EmbeddedDesign/ConsoleLights/hardware/img/ConsoleLights_Render.png

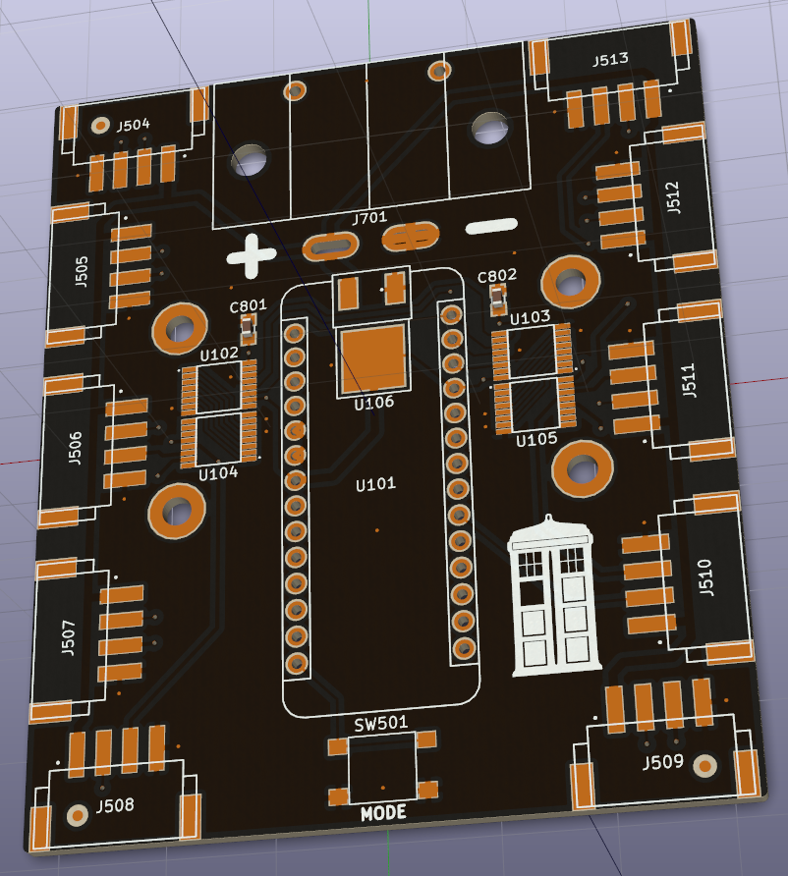
hardware/img/ConsoleLights_Render.png
