EmbeddedDesign/ConsoleLights/README.md

# ConsoleLights
Tardis Console Button and Light Controller
