EmbeddedDesign/ConsoleLights/hardware/img/ConsoleLights_NoPour.png

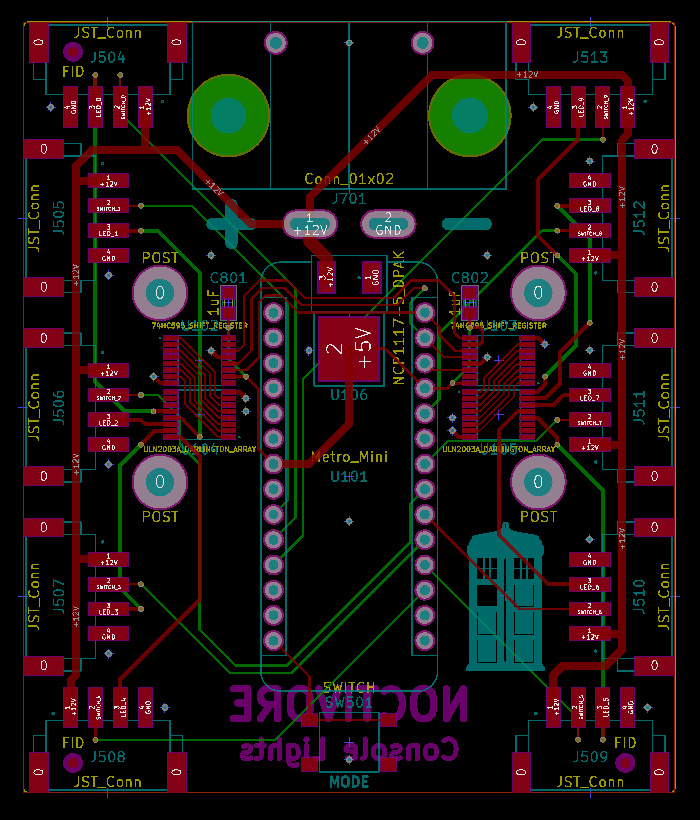
hardware/img/ConsoleLights_NoPour.png
