EmbeddedDesign/ConsoleLights/hardware/img/ConsoleLights_NoPour_Sheet.png

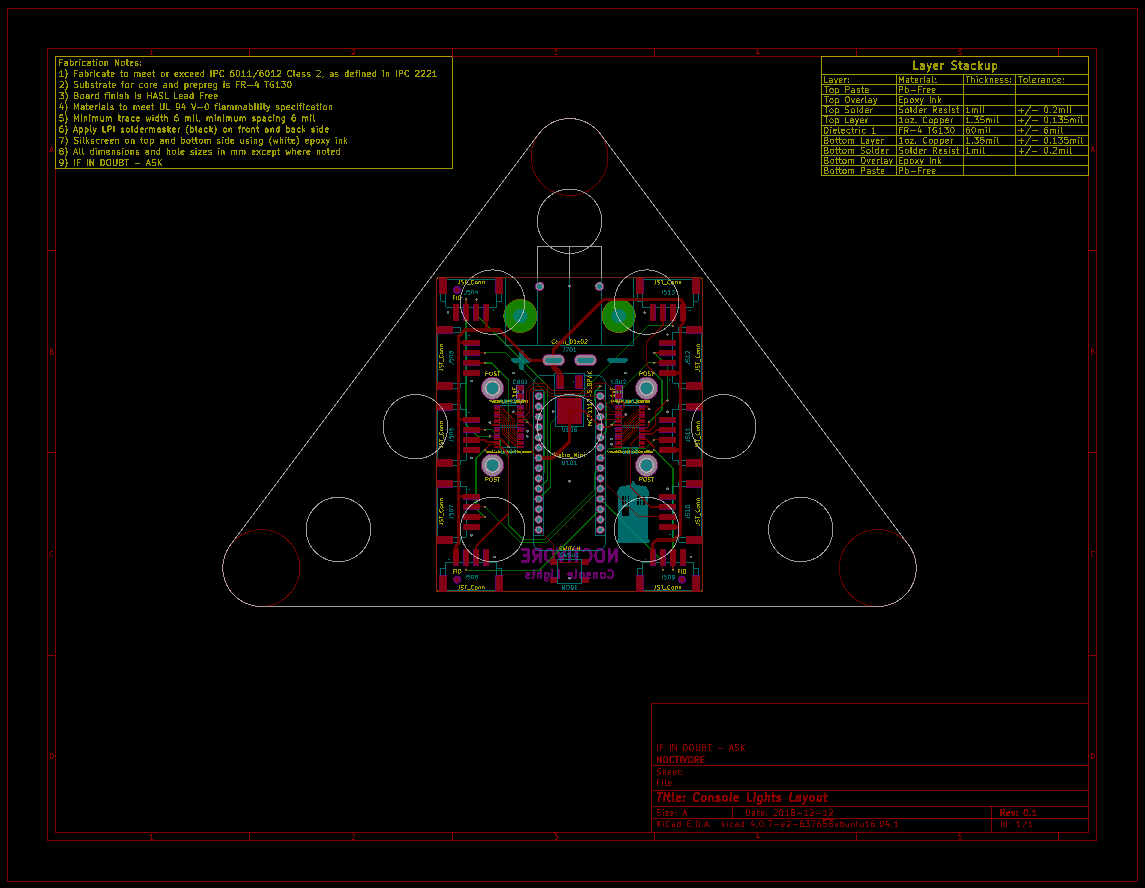
hardware/img/ConsoleLights_NoPour_Sheet.png
