EmbeddedDesign/ConsoleLights/hardware/Console_Lights_BOM.xlsx

Sheet: Console Lights PCBA
Console Lights PCBA BOM v0.1
REF | QTY | MRF | MFRPN | DESCRIPTION | PACKAGE | DATASHEET | LINK | 2ND SOURCE | ALT
U101 | 1 | Adafruit | 2590 | Metro Mini 328 5V 16MHz | Custom | https://cdn-learn.adafruit.com/downloads/pdf/adafruit-metro-mini.pdf | https://www.arrow.com/en/products/2590/adafruit-industries | https://www.adafruit.com/product/2590
U102, U103 | 2 | Nexperia | 74HC595PW-Q100,118 | 8-bit Shift Register | 16-TSSOP | https://assets.nexperia.com/documents/data-sheet/74HC_HCT595_Q100.pdf | https://www.arrow.com/en/products/74hc595pw-q100118/nexperia | https://www.digikey.com/product-detail/en/nexperia-usa-inc/74HC595PW-Q100118/1727-1012-1-ND/3749019 | MC74HC595ADTR2G, SN74HC595PWR
U104, U105 | 2 | TI | ULN2003APWR | High-Current Darlington Transistor Array | 16-TSSOP | http://www.ti.com/lit/ds/symlink/uln2003a.pdf | https://www.arrow.com/en/products/uln2003apwr/texas-instruments | https://www.digikey.com/product-detail/en/texas-instruments/ULN2003APWR/296-27173-1-ND/2255408 | ULN2003V12T16-13
U106 | 1 | On Semi | NCP1117DT50RKG | 5V Linear Regulator | DPAK | http://www.onsemi.com/pub/Collateral/NCP1117-D.PDF | https://www.arrow.com/en/products/ncp1117dt50rkg/on-semiconductor | https://www.digikey.com/products/en/integrated-circuits-ics/pmic-voltage-regulators-linear/699?k=NCP1117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
J501 | 1 | Anderson Power | ASMPR45-1X2-RK | Single Row 1x2 Powerpole Assembly | Custom | https://www.andersonpower.com/_global-assets/downloads/pdf/b02021s.pdf | https://www.mouser.com/ProductDetail/Anderson-Power-Products/ASMPR45-1X2-RK?qs=tub3WQyKOl%2FsXEao4JOdAw%3D%3D
J502, J503 | 2 | Sullins | PPPC141LFBN-RC | Conn Header Female 14POS 2.54mm | 2.54x14 | https://drawings-pdf.s3.amazonaws.com/10492.pdf | https://www.digikey.com/product-detail/en/sullins-connector-solutions/PPPC141LFBN-RC/S7047-ND/810186 |  | PPTC141LFBN-RC
J504-J513 | 10 | JST | S4B-XH-SM4-TB(LF)(SN) | Conn Header XH Side 4POS 2.5mm | Custom | http://www.jst-mfg.com/product/pdf/eng/eXH.pdf | https://www.arrow.com/en/products/s4b-xh-sm4-tb-lf-sn/jst-manufacturing | https://www.digikey.com/product-detail/en/jst-sales-america-inc/S4B-XH-SM4-TB-LF-SN/455-2262-1-ND/1651060 | http://www.farnell.com/datasheets/5448.pdf
C801, C802 | 2 | Samsung | CL10B105KP8NNNC | 1uF Capacitor, +/- 10%, 10V, X5/7R | 0603 | https://www.samsungsem.com/kr/support/product-search/mlcc/__icsFiles/afieldfile/2016/08/18/S_CL10B105KP8NNNC.pdf | https://www.arrow.com/en/products/cl10b105kp8nnnc/samsung-electro-mechanics | https://www.digikey.com/product-detail/en/samsung-electro-mechanics/CL10B105KP8NNNC/1276-1946-1-ND/3890032 | CL10B105KP8NNNC, 0603YC105KAT2A
SW1 | 1 | Panasonic | PTS645SM43SMTR92 LFS | SPST Off-Mom Tactile Switch | Custom | http://www.ckswitches.com/media/1471/pts645.pdf | https://www.arrow.com/en/products/pts645sm43smtr92lfs/ck | https://www.digikey.com/product-detail/en/c-k/PTS645SM43SMTR92-LFS/CKN9112CT-ND/1146934 | EVQ-Q2P02W, EVQ-Q2P03W, EVQ-Q2K03W

Sheet: Console Lights Other
Console Lights Other
QTY | MRF | MFRPN | DESCRIPTION | DATASHEET | LINK | 2ND SOURCE
40 | JST | SXH-001T-P0.6 | Conn Terminal Crimp XH 22AWG | http://www.jst-mfg.com/product/pdf/eng/eXH.pdf | https://www.digikey.com/product-detail/en/jst-sales-america-inc/SXH-001T-P0.6/455-1135-1-ND/527370 | https://www.arrow.com/en/products/sxh-001t-p0.6/jst-manufacturing
10 | JST | XHP-4 | Conn Housing 4POS 2.5mm | http://www.jst-mfg.com/product/pdf/eng/eXH.pdf | https://www.arrow.com/en/products/xhp-4/jst-manufacturing | https://www.digikey.com/product-detail/en/jst-sales-america-inc/XHP-4/455-2267-ND/683353
20 | TE | 42470-1 | Conn Quick Connect 0.110 x 0.020 Tab | https://www.te.com/commerce/DocumentDelivery/DDEController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 | https://www.digikey.com/product-detail/en/te-connectivity-amp-connectors/42470-1/42470-1-ND/298087 | https://www.arrow.com/en/products/42470-1/te-connectivity
20 | TE | 60118-1 | Conn Quick Connect 0.110 x 0.016 Tab | https://www.te.com/commerce/DocumentDelivery/DDEController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 | https://www.digikey.com/product-detail/en/te-connectivity-amp-connectors/60118-1/A27748CT-ND/456836
2 | Anderson Power | 1399G8-BK | Mounting Wing, Blue | https://www.mouser.com/datasheet/2/22/AndersonPower_01102017_DS-PP1545-1158138.pdf | https://www.mouser.com/ProductDetail/Anderson-Power-Products/1399G8-BK
1 | Anderson Power | 110G16 | Retaining Pin | https://www.mouser.com/datasheet/2/22/AndersonPower_01102017_DS-PP1545-1158138.pdf | https://www.mouser.com/ProductDetail/Anderson-Power-Products/110G16
1 | Anderson Power | 114555P2 | PCB Mounting Staple | https://www.andersonpower.com/_global-assets/downloads/pdf/b02021s.pdf | https://www.mouser.com/ProductDetail/Anderson-Power-Products/114555P2
2 | McMaster-Carr | 91290A383 | M3.5 Socket Head Screw 12mm Black Oxide | https://www.mcmaster.com/91290a383 | https://www.mcmaster.com/91290a383
2 | McMaster-Carr | 94150A330 | M3.5 Hex Nut | https://www.mcmaster.com/94150a330 | https://www.mcmaster.com/94150a330
2 | McMaster-Carr | 90965A140 | M3.5 316 Stainless Steel Washer | https://www.mcmaster.com/90965a140 | https://www.mcmaster.com/90965a140
