EmbeddedDesign/ConsoleLights/hardware/Console_Lights_Drawing.pdf

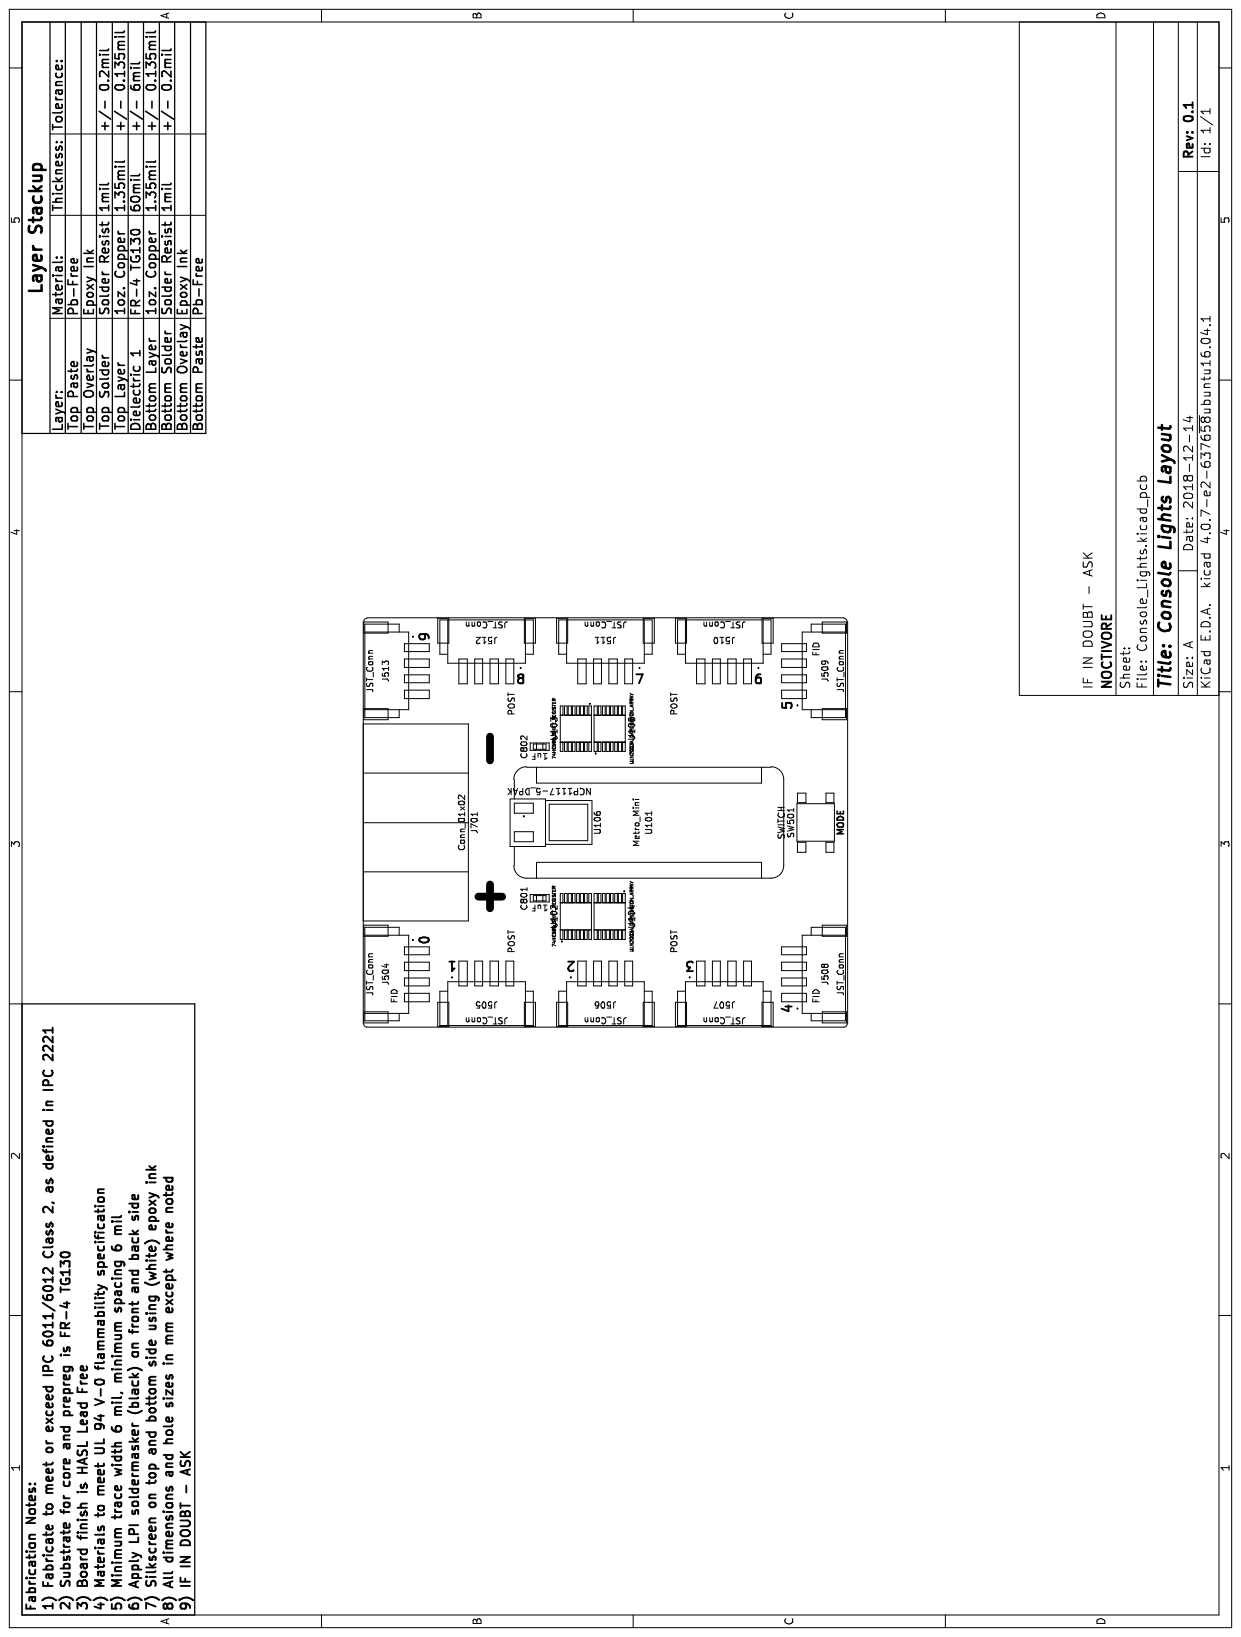
[picture p4: page 1]
