EmbeddedDesign/ConsoleLights/hardware/Console_Lights_Schematics.pdf

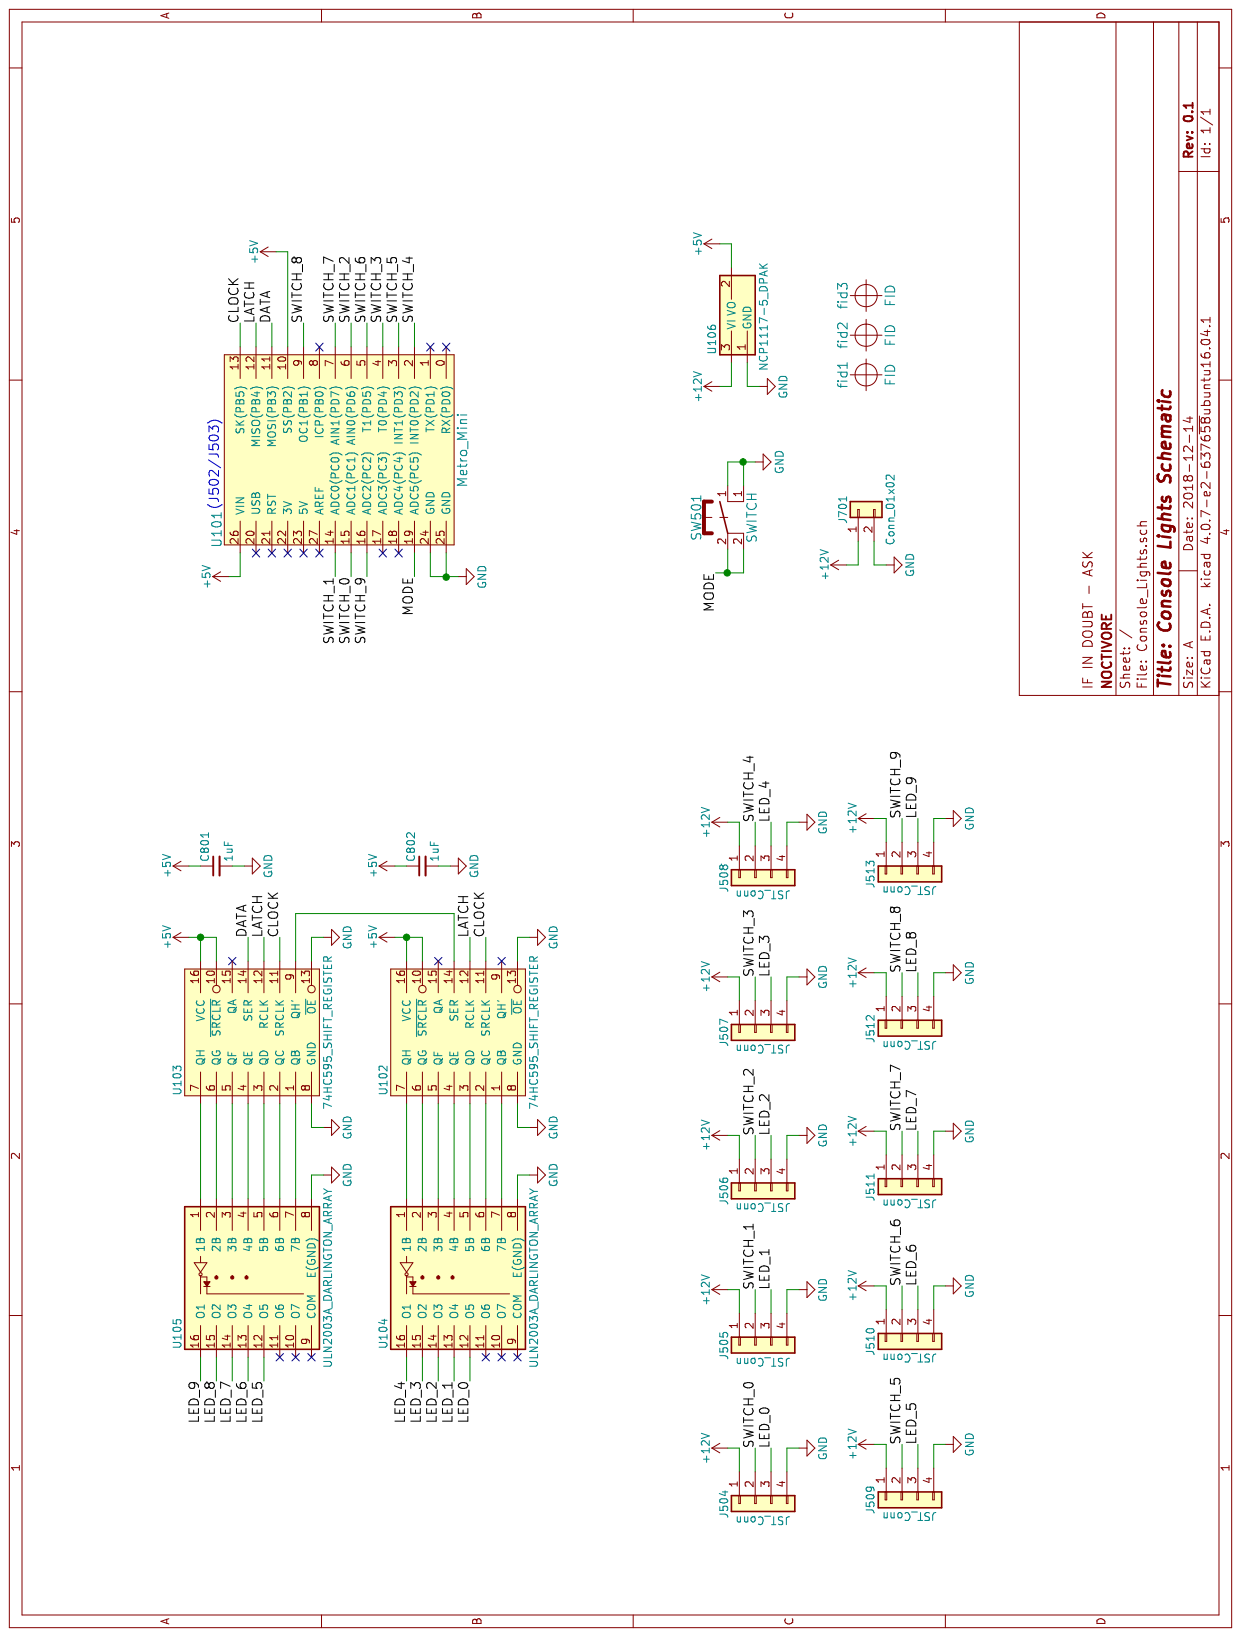
[picture p5: page 1]
