EmbeddedDesign/ConsoleLights/hardware/Console_Lights.kicad_pcb

## KiCad design hardware/Console_Lights.kicad_pcb (2018-12-18)

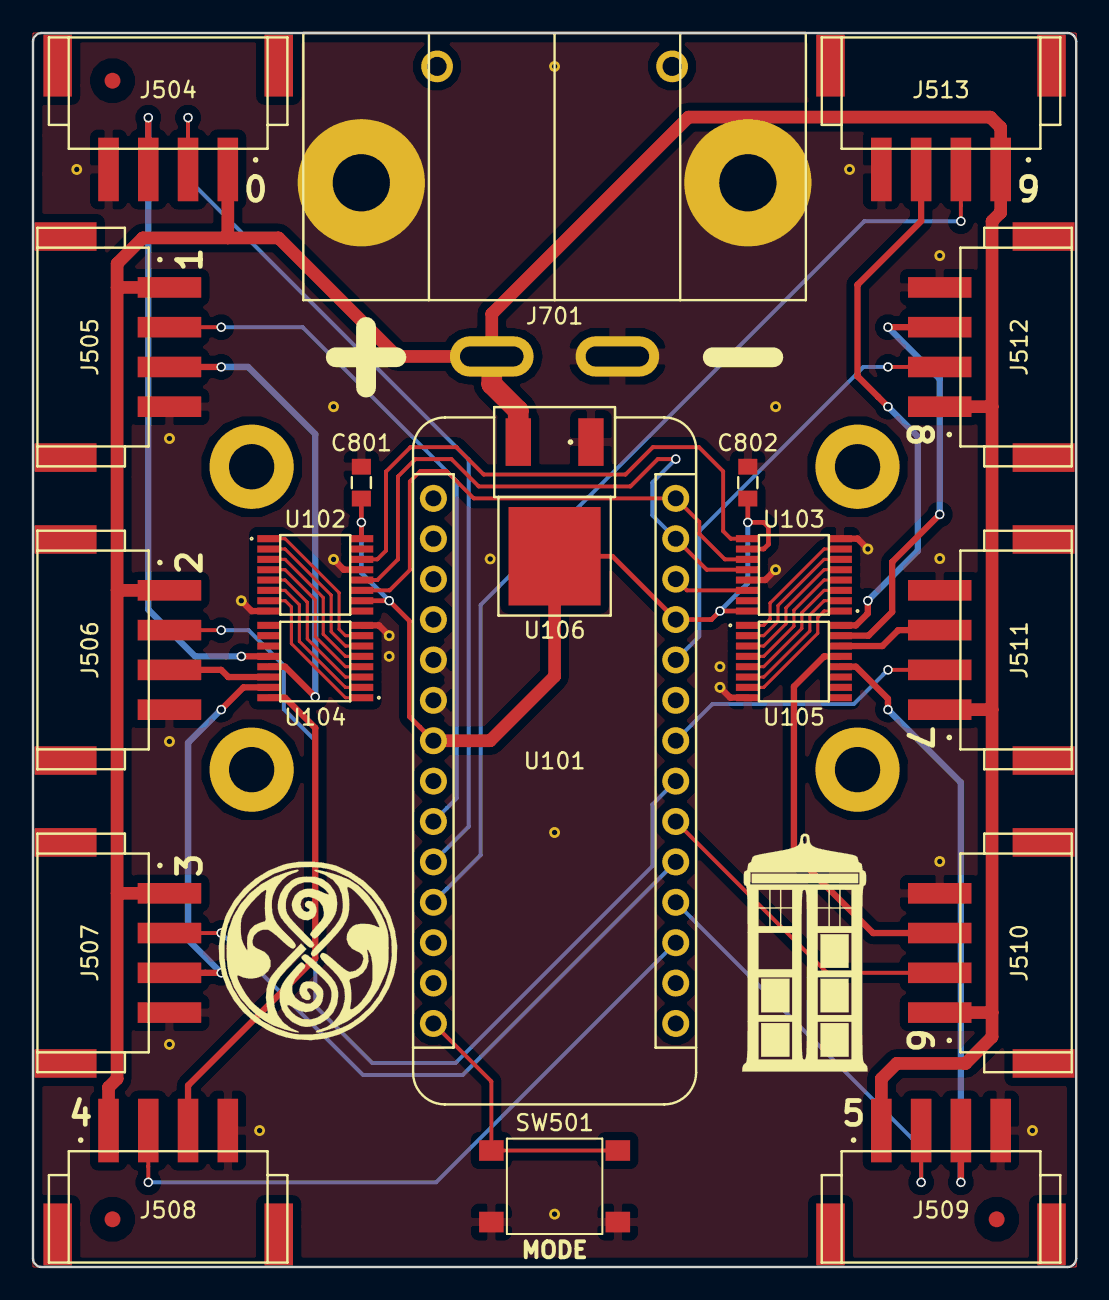
[picture p6: board Console_Lights.kicad_pcb from above]

Board: 2 copper layers, 65.6 x 77.6 mm, 23 parts (0 on the bottom side), 42 nets.

Parts:
C801, C802: 1uF; C_0603
J504, J505, J506, J507, J508, J509, J510, J511, J512, J513: JST_Conn; S4B-XH-SM4-TB
J701: Conn_01x02; ASMPR45-1X2-RK_Wings
SW501: SWITCH; CK_PTS645_Tac_Switch
U101: Metro_Mini
U102, U103: 74HC595_SHIFT_REGISTER; 16-TSSOP
U104, U105: ULN2003A_DARLINGTON_ARRAY; 16-TSSOP
U106: NCP1117-5_DPAK; DPAK_TO-252
fid1, fid2, fid3: FID; Fiducial

Connections:
+5V: C801.1, C802.1, U101.10, U101.26, U102.10, U102.16, U103.10, U103.16, U106.2
+12V: J504.1, J505.1, J506.1, J507.1, J508.1, J509.1, J510.1, J511.1, J512.1, J513.1, J701.1, U106.3
/CLOCK: U101.13, U102.11, U103.11
/DATA: U101.11, U103.14
/LATCH: U101.12, U102.12, U103.12
/LED_0: J504.3, U104.12
/LED_1: J505.3, U104.13
/LED_2: J506.3, U104.14
/LED_3: J507.3, U104.15
/LED_4: J508.3, U104.16
/LED_5: J509.3, U105.12
/LED_6: J510.3, U105.13
/LED_7: J511.3, U105.14
/LED_8: J512.3, U105.15
/LED_9: J513.3, U105.16
/MODE: SW501.2, U101.19
/SWITCH_0: J504.2, U101.15
/SWITCH_1: J505.2, U101.14
/SWITCH_2: J506.2, U101.6
/SWITCH_3: J507.2, U101.4
/SWITCH_4: J508.2, U101.2
/SWITCH_5: J509.2, U101.3
/SWITCH_6: J510.2, U101.5
/SWITCH_7: J511.2, U101.7
/SWITCH_8: J512.2, U101.9
/SWITCH_9: J513.2, U101.16
GND: C801.2, C802.2, J504.4, J505.4, J506.4, J507.4, J508.4, J509.4, J510.4, J511.4, J512.4, J513.4, J701.2, SW501.1, U101.24, U101.25, U102.8, U102.13, U103.8, U103.13, U104.8, U105.8, U106.1
unnamed: U102.1, U104.7
unnamed: U102.2, U104.6
unnamed: U102.3, U104.5
unnamed: U102.4, U104.4
unnamed: U102.5, U104.3
unnamed: U102.6, U104.2
unnamed: U102.7, U104.1
unnamed: U102.14, U103.9
unnamed: U103.1, U105.7
unnamed: U103.2, U105.6
unnamed: U103.3, U105.5
unnamed: U103.4, U105.4
unnamed: U103.5, U105.3
unnamed: U103.6, U105.2
unnamed: U103.7, U105.1
