EmbeddedDesign/ConsoleLights/hardware/Quick_Connect_Wiring.png

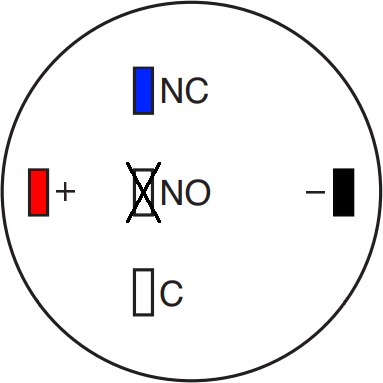
hardware/Quick_Connect_Wiring.png
