EmbeddedDesign/ConsoleLights/(commit log)

2018-10-31 creat lib, add footprints, schematic updates
    [Console_Lights.kicad_pcb, Console_Lights.sch]
2018-11-02 add footprints, BOM, schematic updates
    [Console_Lights.kicad_pcb, Console_Lights.sch, Console_Lights_BOM.xlsx]
2018-11-07 BOM, footprint updates
    [Console_Lights.kicad_pcb, Console_Lights.sch, Console_Lights_BOM.xlsx]
2018-11-09 add regulator, BOM, schematic, layout updates
    [Console_Lights.kicad_pcb, Console_Lights.sch, Console_Lights_BOM.xlsx]
2018-11-10 mounting plate outline, floor-planning
    [Console_Lights.kicad_pcb]
2018-11-29 schematic/routing update
    [Console_Lights.kicad_pcb, Console_Lights.sch]
2018-11-30 routing updates
    [Console_Lights.kicad_pcb, Console_Lights.sch]
2018-11-30 routing updates, logo
    [Console_Lights.kicad_pcb, Console_Lights.sch]
2018-12-07 shcematic/routing updates, add fab notes
    [Console_Lights.kicad_pcb, Console_Lights.sch]
2018-12-13 layout updates
    [Console_Lights.kicad_pcb, Console_Lights.sch, Console_Lights_BOM.xlsx]
2018-12-14 add seal, prints, production files
    [Console_Lights-B.Cu.gbl, Console_Lights-B.Mask.gbs, Console_Lights-B.SilkS.gbo, Console_Lights-Edge.Cuts.gm1, Console_Lights-F.Cu.gtl, Console_Lights-F.Fab.gbr, Console_Lights-F.Mask.gts, Console_Lights-F.Paste.gtp]
2018-12-18 production file update
    [Console_Lights-B.Cu.gbl, Console_Lights-B.Mask.gbs, Console_Lights-B.SilkS.gbo, Console_Lights-Edge.Cuts.gm1, Console_Lights-F.Cu.gtl, Console_Lights-F.Fab.gbr, Console_Lights-F.Mask.gts, Console_Lights-F.Paste.gtp]
2019-01-02 add quick-connects to BOM
    [Console_Lights_BOM.xlsx]
2019-01-06 quick connect update
    [Console_Lights_BOM.xlsx]
2019-01-23 cleanup, add interrupt based test code
2019-01-26 interrupt based code, cleanup
2019-01-26 quick connect wiring diagram
2019-01-29 slightly faster, more efficient code, onOff bug fix
    [console_lights_interrupt.ino]
